Socketto/ESP32_USB_demo/board/images/jlcpcb-u2-prima-correzione.png

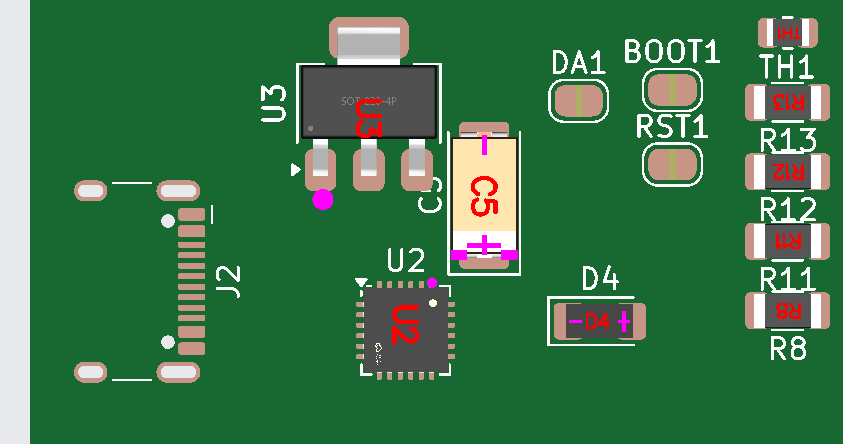
board/images/jlcpcb-u2-prima-correzione.png
