Socketto/ESP32_USB_demo/board/board.kicad_pcb

## KiCad design board/board.kicad_pcb (2026-11-05)

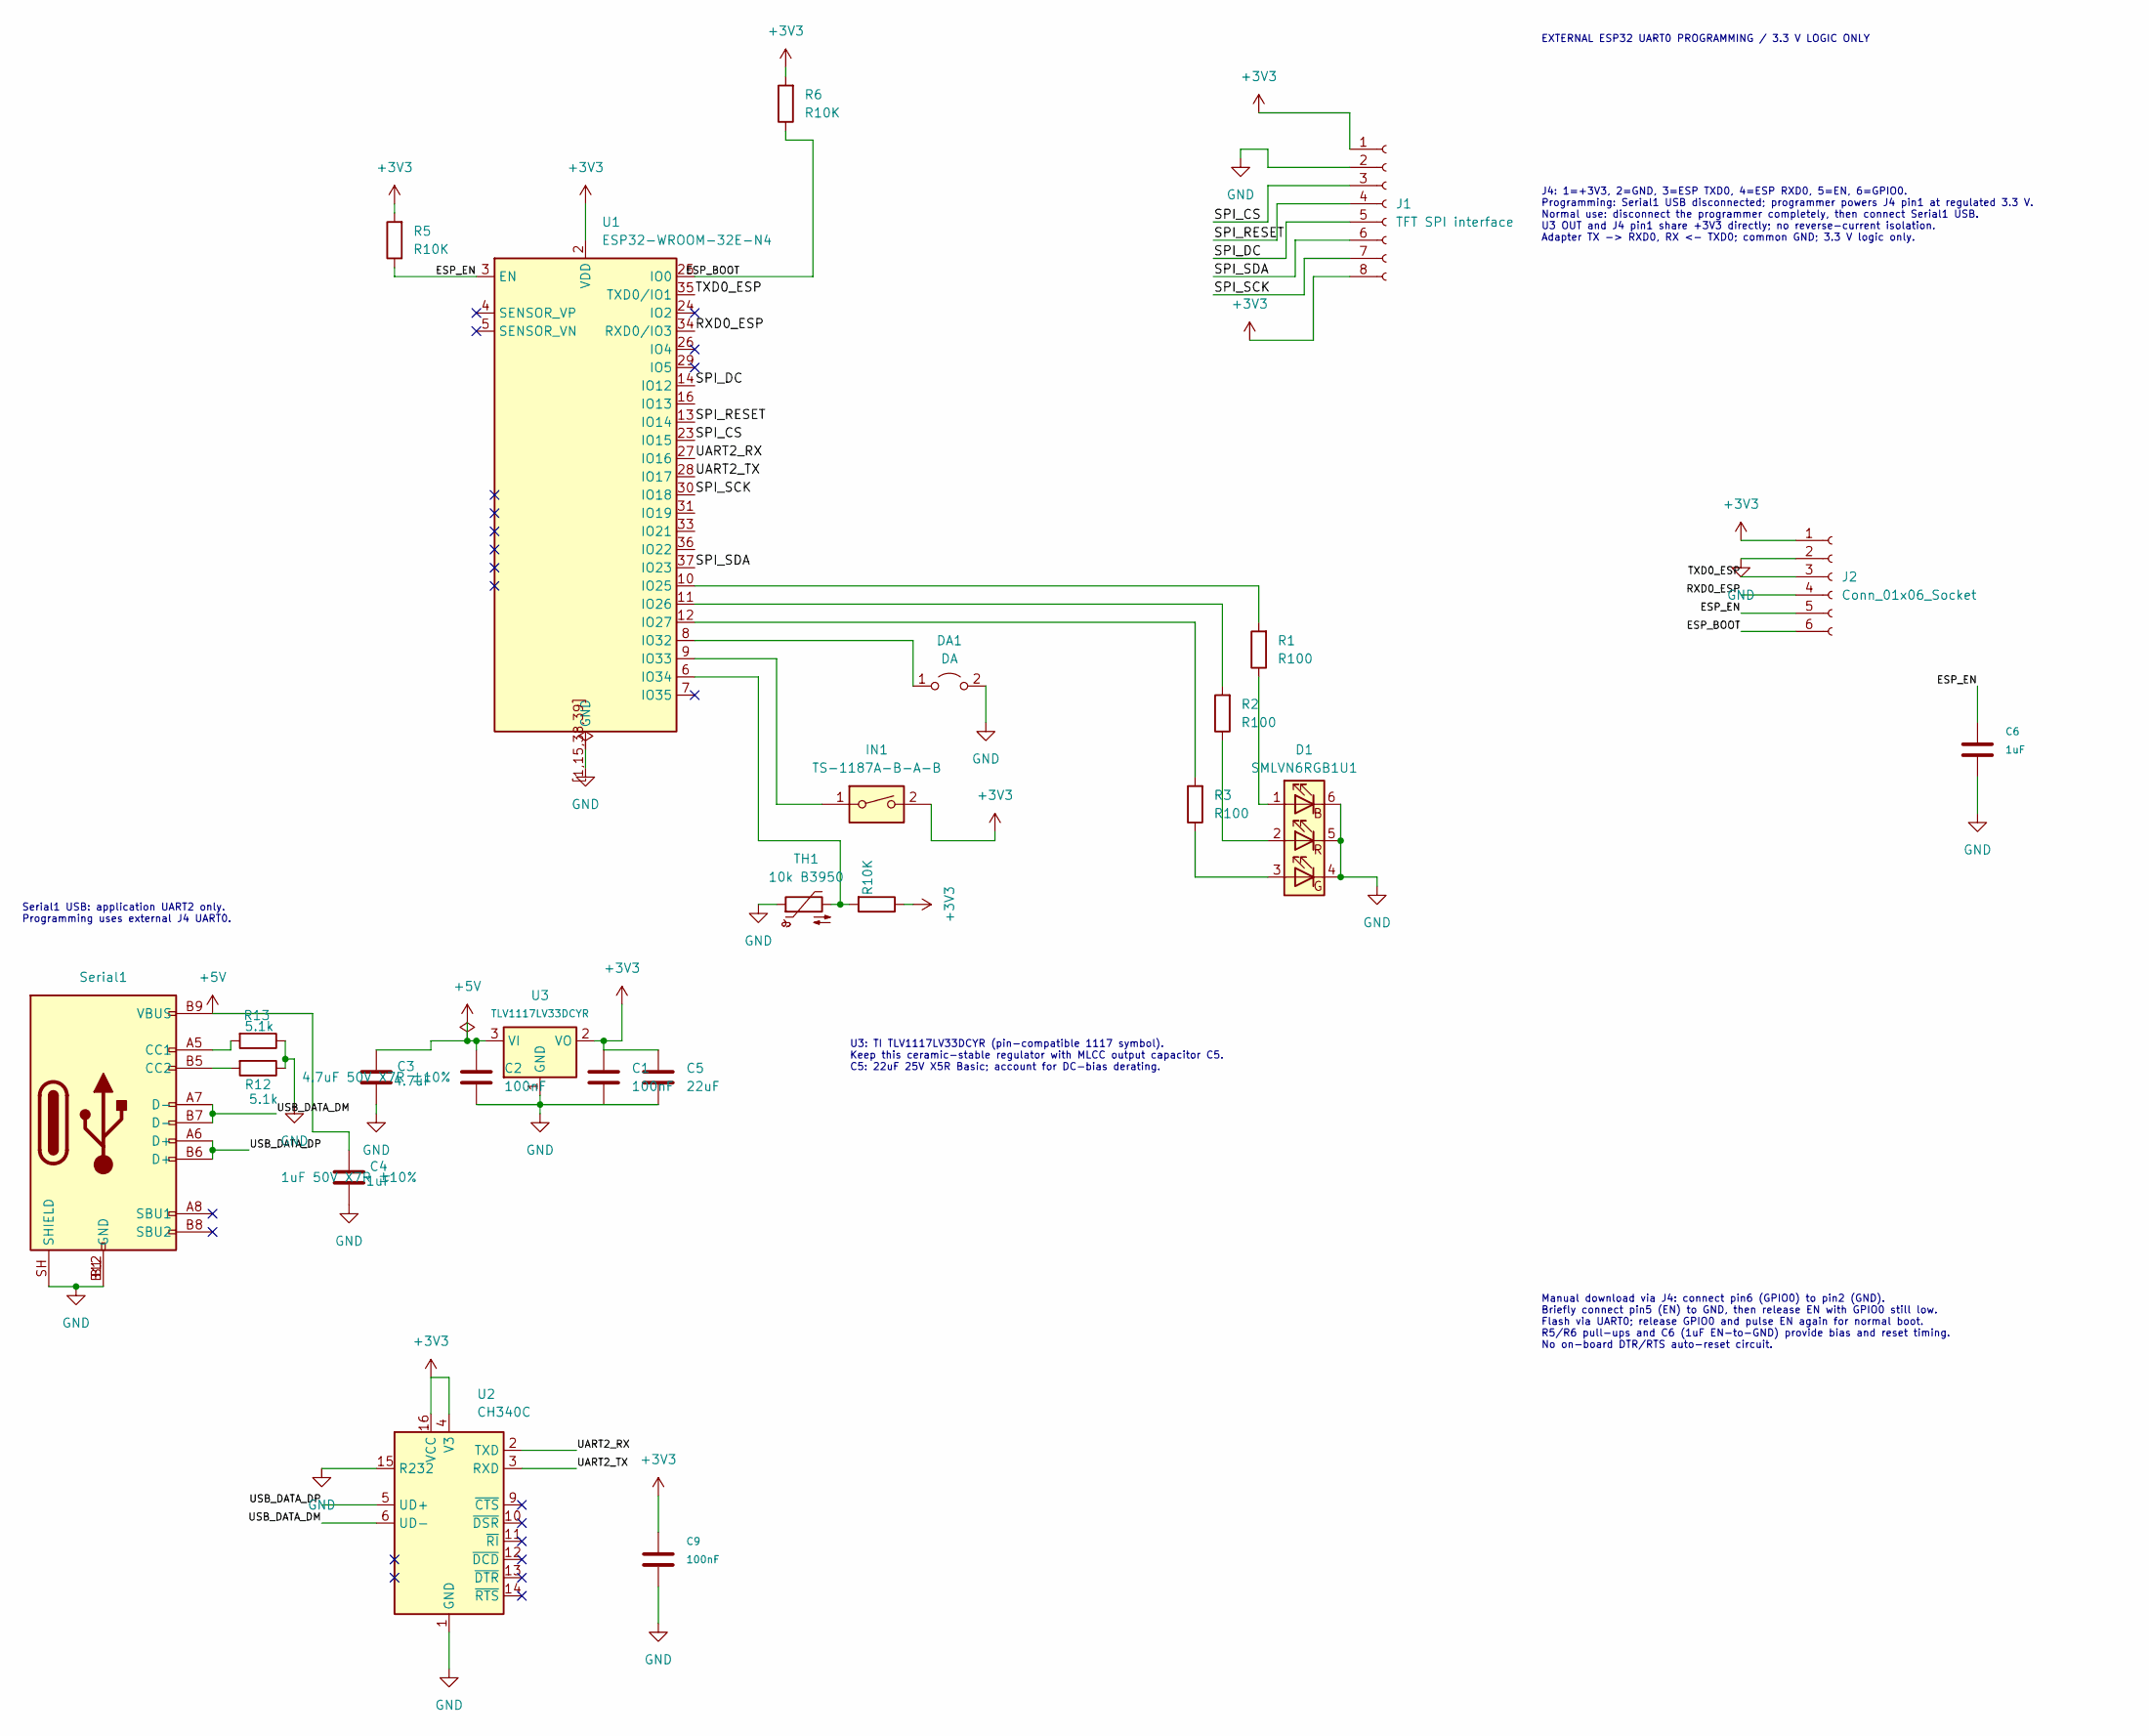
[picture p2: schematic board.kicad_sch]

Parts:
C1, C2, C9: 100nF; C_1206_3216Metric; MPN CL31B104KBCNNNC; LCSC C24497
C3: 4.7uF; C_1206_3216Metric; MPN 1206B475K500NT; LCSC C29823
C4, C6: 1uF; C_1206_3216Metric; MPN CL31B105KBHNNNE; LCSC C1848
C5: 22uF; C_1206_3216Metric; MPN CL31A226KAHNNNE; LCSC C12891
D1: SMLVN6RGB1U1; LED_ROHM_SMLVN6; MPN SMLVN6RGB1U1; LCSC C2909770
DA1: DA; PinHeader_1x02_P2.54mm_Vertical
IN1: TS-1187A-B-A-B; SW_Push_1P1T_XKB_TS-1187A; MPN TS-1187A-B-A-B; LCSC C318884
J1: TFT SPI interface; PinHeader_1x08_P2.54mm_Vertical
J2: Conn_01x06_Socket; PinHeader_1x06_P2.54mm_Vertical
R1, R2, R3: R100; R_1206_3216Metric; MPN 1206W4F1000T5E; LCSC C17901
R5, R6, R8: R10K; R_1206_3216Metric; MPN 1206W4F1002T5E; LCSC C17902
R12, R13: 5.1k; R_0603_1608Metric; MPN 0603WAF5101T5E; LCSC C23186
Serial1: HC-TYPE-C-16P-01A; USB_C_Receptacle_HCTL_HC-TYPE-C-16P-01A; MPN HC-TYPE-C-16P-01A; LCSC C2894897
TH1: 10k B3950; R_0805_2012Metric; MPN CMFB103J3950HANT; LCSC C338623
U1: ESP32-WROOM-32E-N4; ESP32-WROOM-32E; MPN ESP32-WROOM-32E-N4; LCSC C701341
U2: CH340C; SOIC-16_3.9x9.9mm_P1.27mm; MPN CH340C; LCSC C84681
U3: TLV1117LV33DCYR; SOT-223-3_TabPin2; MPN TLV1117LV33DCYR; LCSC C15578

Connections:
+3V3: C1.1, C5.1, C9.1, IN1.2, J1.1, J1.8, J2.1, R5.2, R6.2, R8.1, U1.2 (VDD), U2.4 (V3), U2.16 (VCC), U3.2 (VO)
+5V: C2.1, C3.1, C4.1, Serial1.A4 (VBUS), Serial1.A9 (VBUS), Serial1.B4 (VBUS), Serial1.B9 (VBUS), U3.3 (VI)
/ESP_BOOT: J2.6, R6.1, U1.25 (IO0)
/ESP_EN: C6.1, J2.5, R5.1, U1.3 (EN)
/RXD0_ESP: J2.4, U1.34 (RXD0/IO3)
/SPI_CS: J1.3, U1.23 (IO15)
/SPI_DC: J1.5, U1.14 (IO12)
/SPI_RESET: J1.4, U1.13 (IO14)
/SPI_SCK: J1.7, U1.30 (IO18)
/SPI_SDA: J1.6, U1.37 (IO23)
/TXD0_ESP: J2.3, U1.35 (TXD0/IO1)
/UART2_RX: U1.27 (IO16), U2.2 (TXD)
/UART2_TX: U1.28 (IO17), U2.3 (RXD)
/USB_DATA_DM: Serial1.A7 (D-), Serial1.B7 (D-), U2.6 (UD-)
/USB_DATA_DP: Serial1.A6 (D+), Serial1.B6 (D+), U2.5 (UD+)
GND: C1.2, C2.2, C3.2, C4.2, C5.2, C6.2, C9.2, D1.4 (GK), D1.5 (RK), D1.6 (BK), DA1.2 (B), J1.2, J2.2, R12.1, R13.1, Serial1.A1 (GND), Serial1.A12 (GND), Serial1.B1 (GND), Serial1.B12 (GND), Serial1.SH (SHIELD), TH1.1, U1.1 (GND), U1.15 (GND), U1.38 (GND), U1.39 (GND), U1.[1,15,38,39] (GND), U2.1 (GND), U2.15 (R232), U3.1 (GND)
unnamed: D1.1 (BA), R1.1
unnamed: D1.3 (GA), R3.1
unnamed: D1.2 (RA), R2.1
unnamed: DA1.1 (A), U1.8 (IO32)
unnamed: R13.2, Serial1.A5 (CC1)
unnamed: R12.2, Serial1.B5 (CC2)
unnamed: R1.2, U1.10 (IO25)
unnamed: R2.2, U1.11 (IO26)
unnamed: R3.2, U1.12 (IO27)
unnamed: IN1.1, U1.9 (IO33)
unnamed: R8.2, TH1.2, U1.6 (IO34)

Notes on the sheet:
Serial1 USB: application UART2 only. Programming uses external J4 UART0.
J4: 1=+3V3, 2=GND, 3=ESP TXD0, 4=ESP RXD0, 5=EN, 6=GPIO0. Programming: Serial1 USB disconnected; programmer powers J4 pin1 at regulated 3.3 V. Normal use: disconnect the programmer completely, then connect Serial1 USB. U3 OUT and J4 pin1 share +3V3 directly; no reverse-current isolation. Adapter TX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
EXTERNAL ESP32 UART0 PROGRAMMING / 3.3 V LOGIC ONLY
U3: TI TLV1117LV33DCYR (pin-compatible 1117 symbol). Keep this ceramic-stable regulator with MLCC output capacitor C5. C5: 22uF 25V X5R Basic; account for DC-bias derating.
Manual download via J4: connect pin6 (GPIO0) to pin2 (GND). Briefly connect pin5 (EN) to GND, then release EN with GPIO0 still low. Flash via UART0; release GPIO0 and pulse EN again for normal boot. R5/R6 pull-ups and C6 (1uF EN-to-GND) provide bias and reset timing. No on-board DTR/RTS auto-reset 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

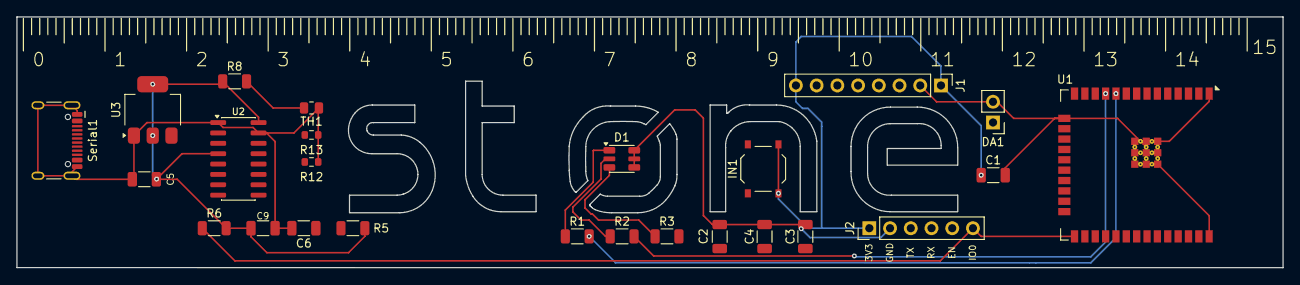
[picture p3: board board.kicad_pcb from above]

Board: 2 copper layers, 155.2 x 30.7 mm, 25 parts (0 on the bottom side), 27 nets.
