Socketto/ESP32_USB_demo/(commit log)

2026-10-30 [FIRST] First commit, only draft of schematic
    [board.kicad_pcb, board.kicad_sch]
2026-10-30 [UPD] Update base board
    [board.kicad_pcb, board.kicad_sch]
2026-11-03 [UPD] Update board
    [board.kicad_pcb, board.kicad_sch]
2026-11-04 [UPD] Update board with 2 usb, 1 for flashing and 1 for serial
    [board.kicad_pcb, board.kicad_sch]
2026-11-05 [ADD] Add version with cp2102n and made cheap a version with CH340
    [board.kicad_pcb, board.kicad_sch]
2026-11-05 [ENH] Start to draft connections
    [board.kicad_pcb, board.kicad_sch]
